Protonica-Detectors/hw-adapter-card/3D Models/TSSOP24_Exposed-pad_STM.step

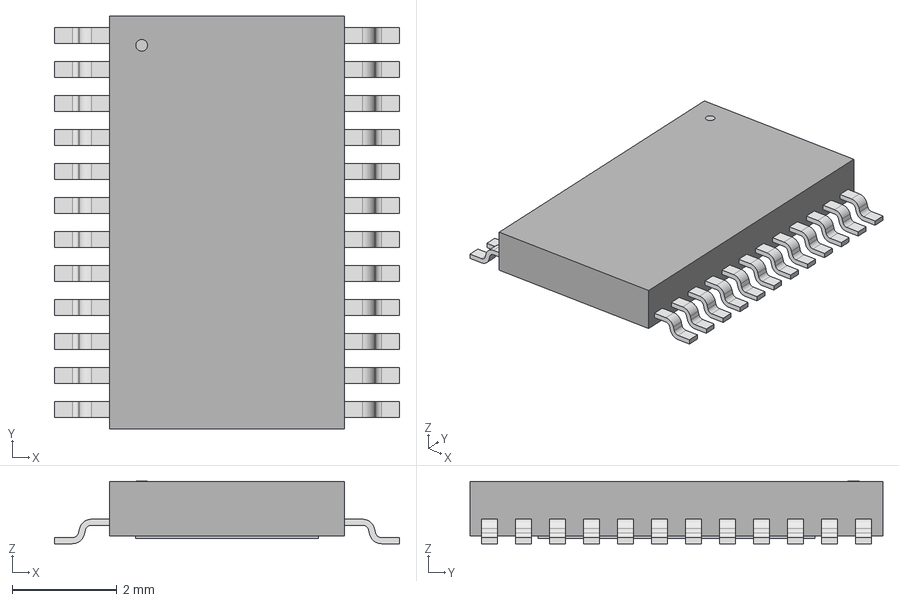
[picture p1: CAD file, 2026-05-28]
3D Models/TSSOP24_Exposed-pad_STM.step
6.60 x 7.90 x 1.20 mm
