Protonica-Detectors/hw-adapter-card/hw-front-end.kicad_pcb

## KiCad design hw-front-end.kicad_pcb (2026-06-15)

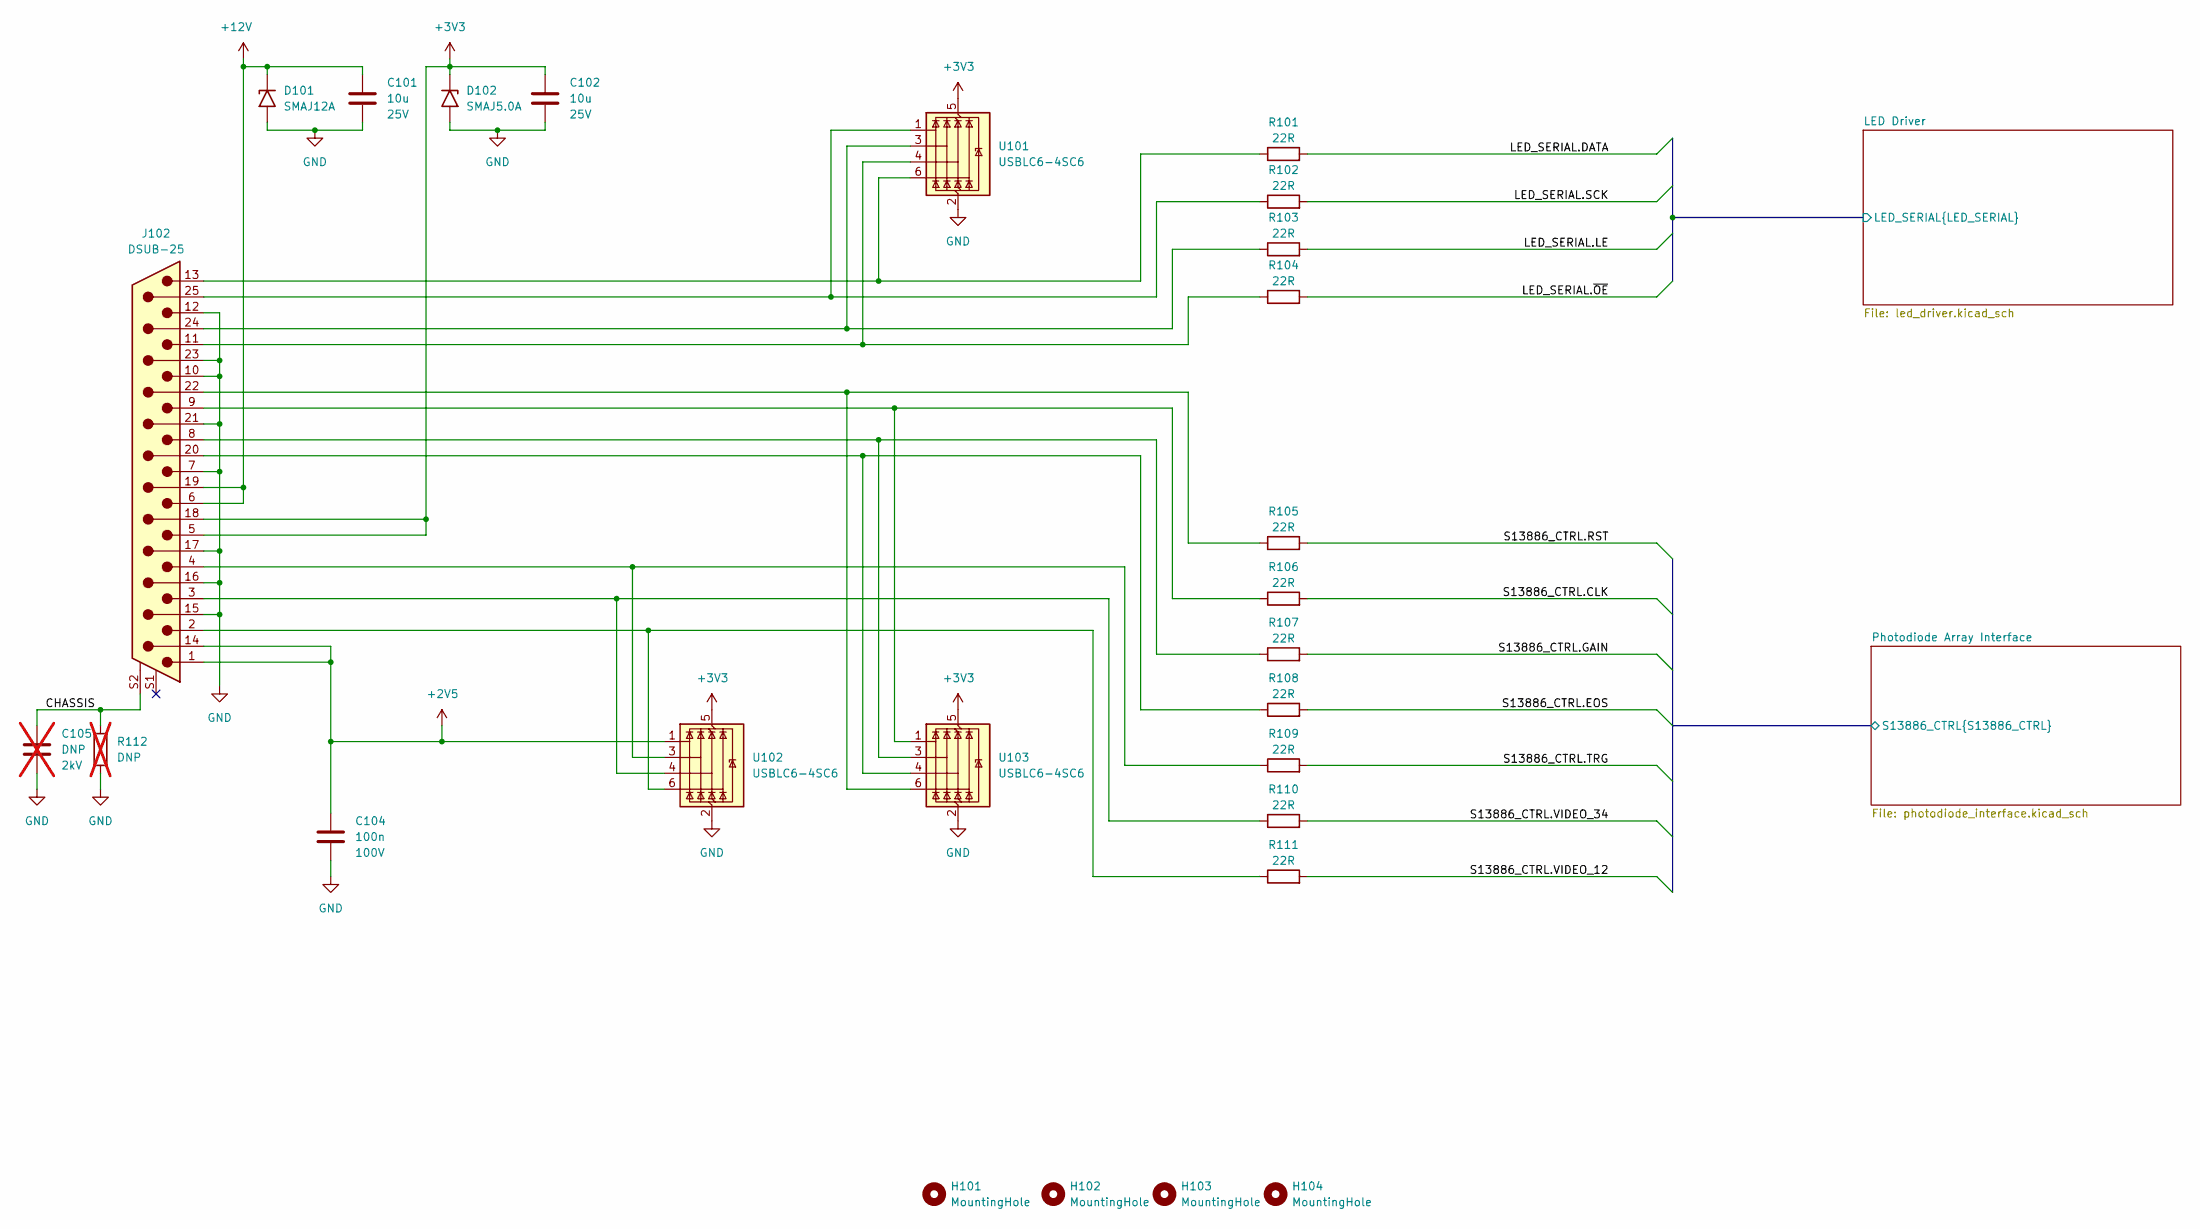
[picture p2: schematic hw-front-end.kicad_sch, Front End Electronics]

Parts:
C101, C102: 10u; C_1206_3216Metric_Pad1.33x1.80mm_HandSolder; Voltage 25V; MPN GRM31CR71E106KA12L
C104: 100n; C_0805_2012Metric_Pad1.18x1.45mm_HandSolder; Voltage 100V; MPN GCM21BR72A104KA37L
C105: DNP; C_1206_3216Metric_Pad1.33x1.80mm_HandSolder; Voltage 2kV; not fitted
D101: SMAJ12A; D_SMA; MPN SMAJ12A
D102: SMAJ5.0A; D_SMA; MPN SMAJ5.0A
H101, H102, H103, H104: MountingHole; MountingHole_3.2mm_M3_DIN965
J102: DSUB-25; J_Wurth_WR-DSUB_618025231221; MPN 618025231221
R101, R102, R103, R104, R105, R106, R107, R108, R109, R110, R111: 22R; R_0805_2012Metric_Pad1.20x1.40mm_HandSolder; MPN CRCW080522R0FKEA
R112: DNP; R_1206_3216Metric_Pad1.30x1.75mm_HandSolder; not fitted
U101, U102, U103: USBLC6-4SC6; SOT-23-6; MPN USBLC6-4SC6

Connections:
+2V5: C104.1, J102.1, J102.14, U102.1 (I/O1); also elsewhere on the board
+3V3: C102.1, D102.1 (A1), J102.5, J102.18, U101.5 (VBUS), U102.5 (VBUS), U103.5 (VBUS); also elsewhere on the board
+12V: C101.1, D101.1 (A1), J102.6, J102.19; also elsewhere on the board
/CHASSIS: C105.1, J102.S2 (SHIELD), R112.1
/LED Driver/LED_SERIAL.DATA: R101.2; also elsewhere on the board
/LED Driver/LED_SERIAL.LE: R103.2; also elsewhere on the board
/LED Driver/LED_SERIAL.SCK: R102.2; also elsewhere on the board
/LED Driver/LED_SERIAL.~OE: R104.2; also elsewhere on the board
/Photodiode Array Interface/S13886_CTRL.CLK: R106.2; also elsewhere on the board
/Photodiode Array Interface/S13886_CTRL.EOS: R108.2; also elsewhere on the board
/Photodiode Array Interface/S13886_CTRL.GAIN: R107.2; also elsewhere on the board
/Photodiode Array Interface/S13886_CTRL.RST: R105.2; also elsewhere on the board
/Photodiode Array Interface/S13886_CTRL.TRG: R109.2; also elsewhere on the board
/Photodiode Array Interface/S13886_CTRL.VIDEO_12: R111.2; also elsewhere on the board
/Photodiode Array Interface/S13886_CTRL.VIDEO_34: R110.2; also elsewhere on the board
GND: C101.2, C102.2, C104.2, C105.2, D101.2 (A2), D102.2 (A2), J102.7, J102.10, J102.12, J102.15, J102.16, J102.17, J102.21, J102.23, R112.2, U101.2 (GND), U102.2 (GND), U103.2 (GND); also elsewhere on the board
unnamed: J102.20, R108.1, U103.4 (I/O3)
unnamed: J102.22, R105.1, U103.6 (I/O4)
unnamed: J102.24, R103.1, U101.3 (I/O2)
unnamed: J102.25, R102.1, U101.1 (I/O1)
unnamed: J102.11, R104.1, U101.4 (I/O3)
unnamed: J102.13, R101.1, U101.6 (I/O4)
unnamed: J102.4, R109.1, U102.3 (I/O2)
unnamed: J102.3, R110.1, U102.4 (I/O3)
unnamed: J102.2, R111.1, U102.6 (I/O4)
unnamed: J102.9, R106.1, U103.1 (I/O1)
unnamed: J102.8, R107.1, U103.3 (I/O2)

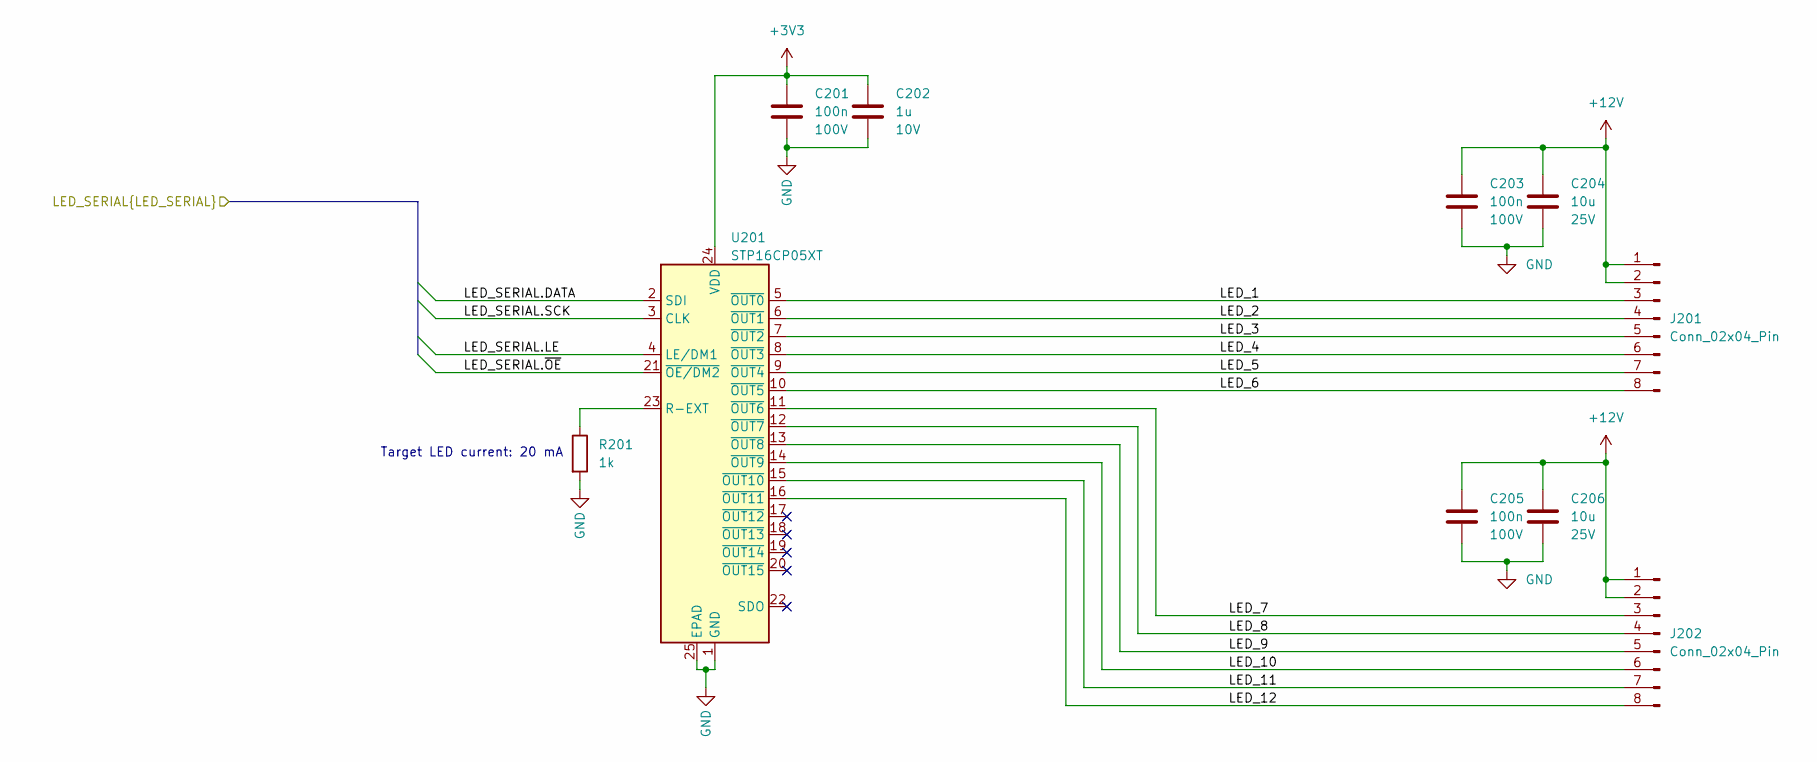
[picture p3: schematic led_driver.kicad_sch, Front End Electronics]

Parts:
C201, C203, C205: 100n; C_0805_2012Metric_Pad1.18x1.45mm_HandSolder; Voltage 100V; MPN GCM21BR72A104KA37L
C202: 1u; C_0805_2012Metric_Pad1.18x1.45mm_HandSolder; Voltage 10V; MPN GRM21BR71A105KA01L
C204, C206: 10u; C_1206_3216Metric_Pad1.33x1.80mm_HandSolder; Voltage 25V; MPN GRM31CR71E106KA12L
J201, J202: Conn_02x04_Pin; PinHeader_2x04_P2.54mm_Vertical; MPN M20-9760442
R201: 1k; R_0805_2012Metric_Pad1.20x1.40mm_HandSolder; MPN CRCW08051K00FKEA
U201: STP16CP05XT; HTSSOP-24-1EP_4.4x7.8mm_P0.65mm_EP3.2x5mm; MPN STP16CP05XTTR

Connections:
+3V3: C201.1, C202.1, U201.24 (VDD); also elsewhere on the board
+12V: C203.1, C204.1, C205.1, C206.1, J201.1, J201.2, J202.1, J202.2; also elsewhere on the board
/LED Driver/LED_1: J201.3, U201.5 (~OUT0)
/LED Driver/LED_2: J201.4, U201.6 (~OUT1)
/LED Driver/LED_3: J201.5, U201.7 (~OUT2)
/LED Driver/LED_4: J201.6, U201.8 (~OUT3)
/LED Driver/LED_5: J201.7, U201.9 (~OUT4)
/LED Driver/LED_6: J201.8, U201.10 (~OUT5)
/LED Driver/LED_7: J202.3, U201.11 (~OUT6)
/LED Driver/LED_8: J202.4, U201.12 (~OUT7)
/LED Driver/LED_9: J202.5, U201.13 (~OUT8)
/LED Driver/LED_10: J202.6, U201.14 (~OUT9)
/LED Driver/LED_11: J202.7, U201.15 (~OUT10)
/LED Driver/LED_12: J202.8, U201.16 (~OUT11)
/LED Driver/LED_SERIAL.DATA: U201.2 (SDI); also elsewhere on the board
/LED Driver/LED_SERIAL.LE: U201.4 (LE/DM1); also elsewhere on the board
/LED Driver/LED_SERIAL.SCK: U201.3 (CLK); also elsewhere on the board
/LED Driver/LED_SERIAL.~OE: U201.21 (~OE/DM2); also elsewhere on the board
GND: C201.2, C202.2, C203.2, C204.2, C205.2, C206.2, R201.2, U201.1 (GND), U201.25 (EPAD); also elsewhere on the board
unnamed: R201.1, U201.23 (R-EXT)

Notes on the sheet:
Target LED current: 20 mA

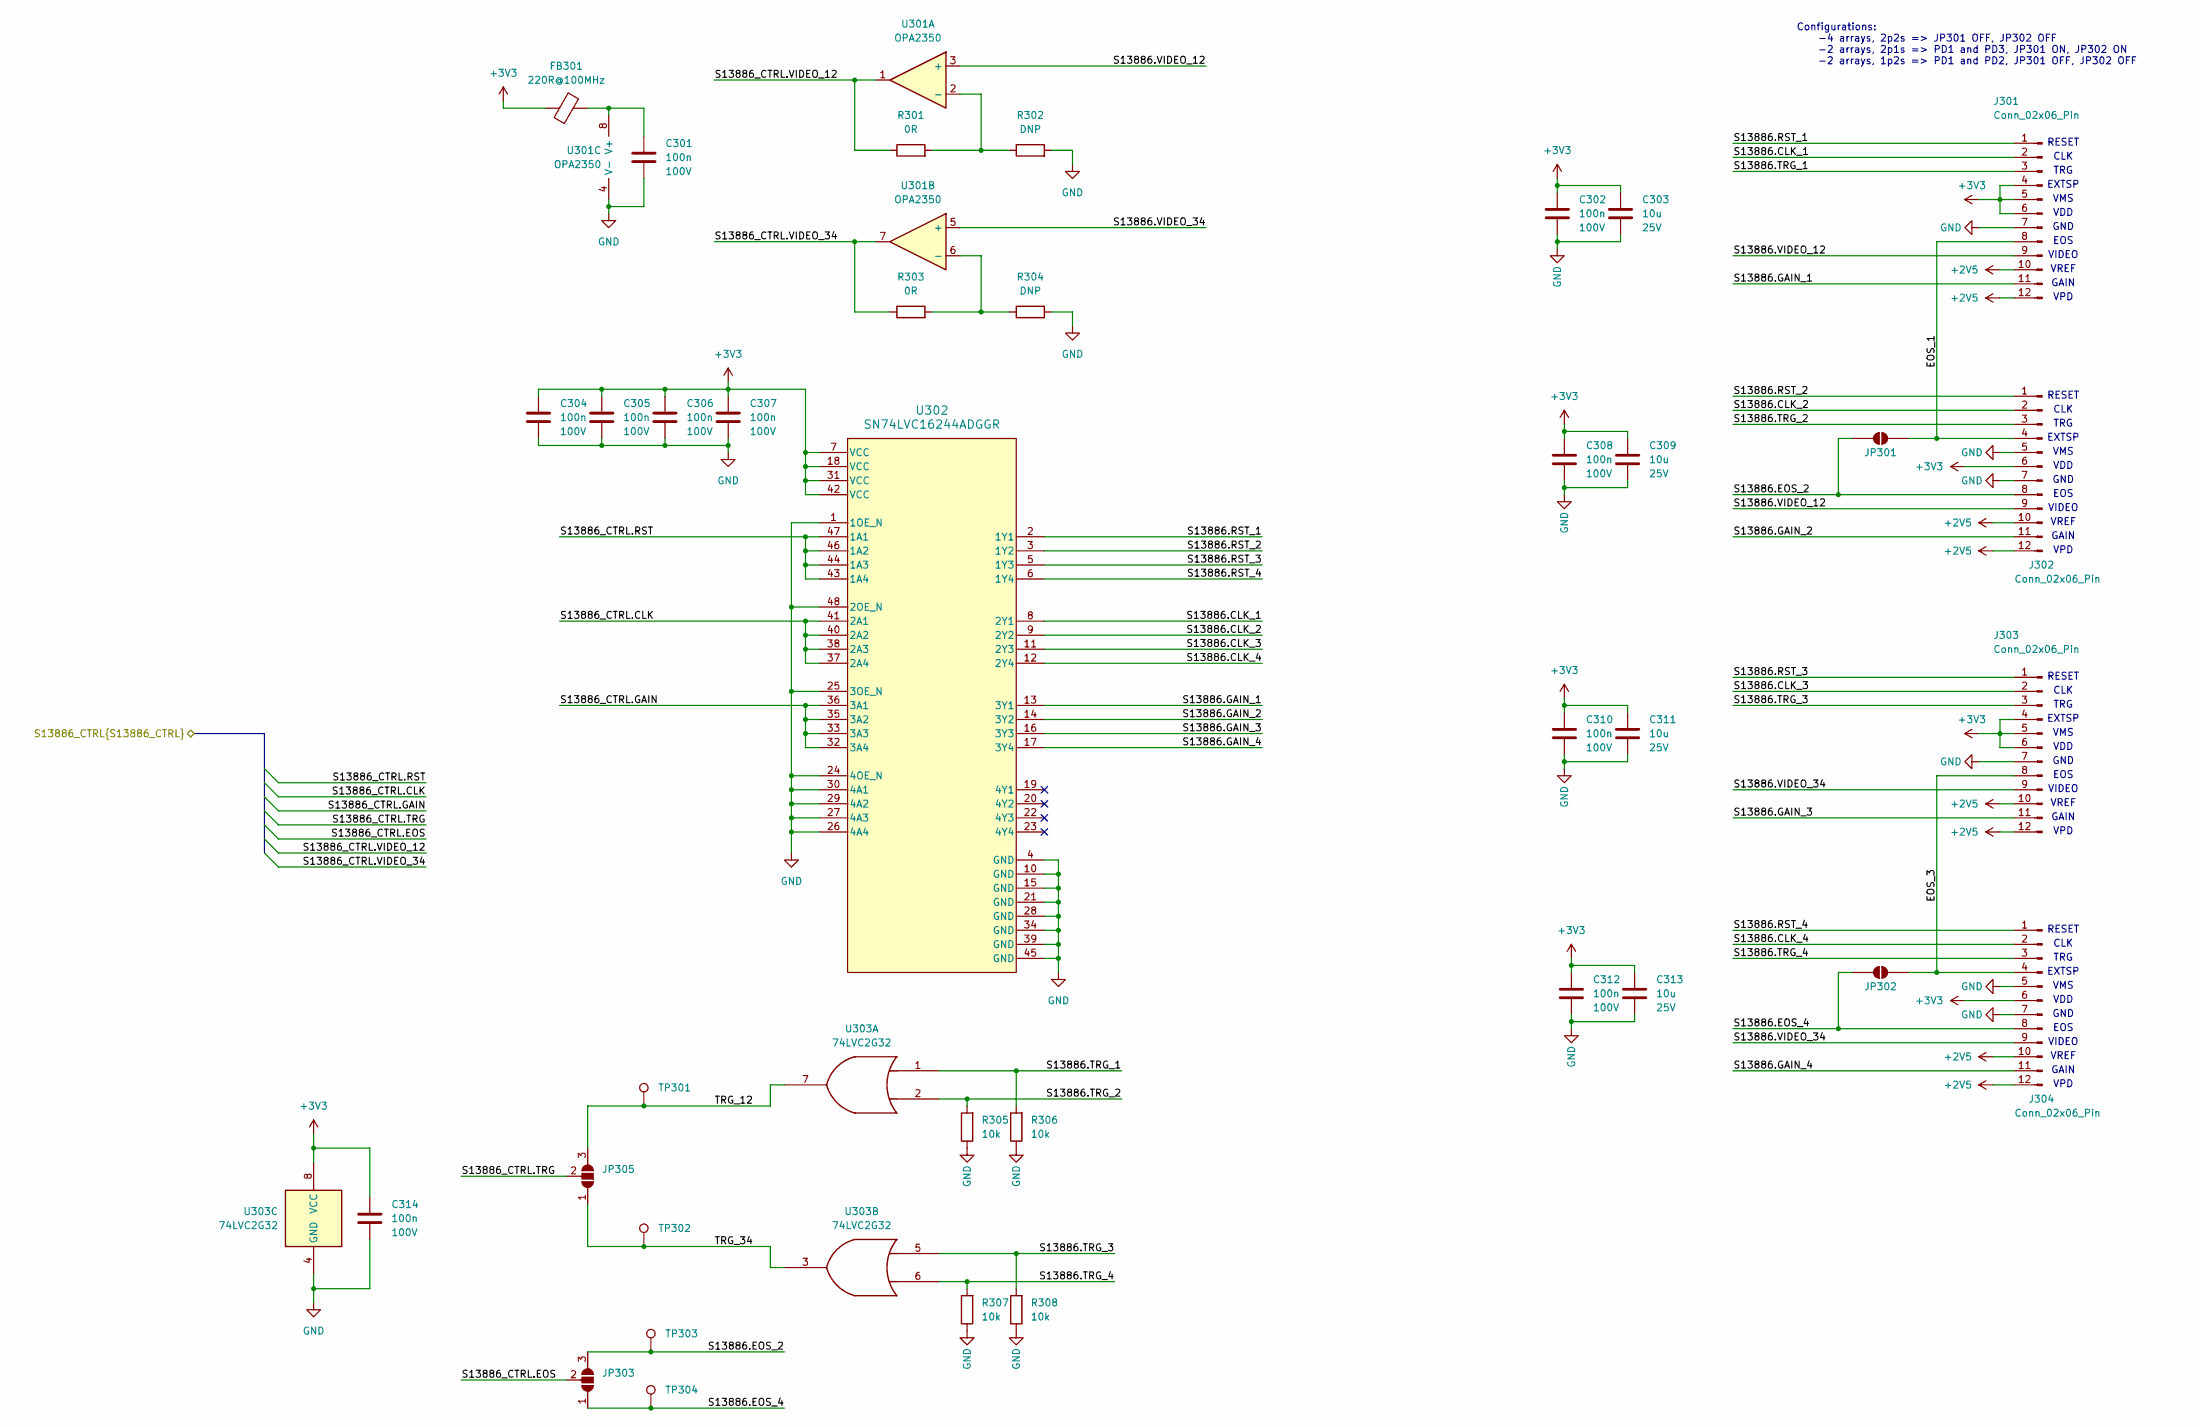
[picture p4: schematic photodiode_interface.kicad_sch, Front End Electronics]

Parts:
C301, C302, C304, C305, C306, C307, C308, C310, C312, C314: 100n; C_0805_2012Metric_Pad1.18x1.45mm_HandSolder; Voltage 100V; MPN GCM21BR72A104KA37L
C303, C309, C311, C313: 10u; C_1206_3216Metric_Pad1.33x1.80mm_HandSolder; Voltage 25V; MPN GRM31CR71E106KA12L
FB301: 220R@100MHz; L_0805_2012Metric_Pad1.05x1.20mm_HandSolder; MPN BLM21PG221SN1D
J301, J302, J303, J304: Conn_02x06_Pin; PinHeader_2x06_P2.54mm_Vertical; MPN M20-9760642
JP301, JP302: SolderJumper_2_Open; SolderJumper-2_P1.3mm_Open_Pad1.0x1.5mm
JP303, JP305: SolderJumper_3_Open; SolderJumper-3_P1.3mm_Open_Pad1.0x1.5mm
R301, R303: 0R; R_0805_2012Metric_Pad1.20x1.40mm_HandSolder; MPN CRCW08050000Z0EA
R302, R304: DNP; R_0805_2012Metric_Pad1.20x1.40mm_HandSolder
R305, R306, R307, R308: 10k; R_0805_2012Metric_Pad1.20x1.40mm_HandSolder; MPN CRCW080510K0FKEA
TP301, TP302, TP303, TP304: TestPoint; TestPoint_Keystone_5005-5009_Compact; MPN 5005
U301: OPA2350; SOIC-8_3.9x4.9mm_P1.27mm; MPN OPA2350UA/2K5
U302: SN74LVC16244ADGGR; TSSOP-48_6.1x12.5mm_P0.5mm; MPN SN74LVC16244ADGGR
U303: 74LVC2G32; VSSOP-8_3x3mm_P0.65mm; MPN SN74LVC2G32DCTR

Connections:
+2V5: J301.10, J301.12, J302.10, J302.12, J303.10, J303.12, J304.10, J304.12; also elsewhere on the board
+3V3: C302.1, C303.1, C304.1, C305.1, C306.1, C307.1, C308.1, C309.1, C310.1, C311.1, C312.1, C313.1, C314.1, FB301.1, J301.4, J301.5, J301.6, J302.6, J303.4, J303.5, J303.6, J304.6, U302.7 (VCC), U302.18 (VCC), U302.31 (VCC), U302.42 (VCC), U303.8 (VCC); also elsewhere on the board
/Photodiode Array Interface/EOS_1: J301.8, J302.4, JP301.1 (A)
/Photodiode Array Interface/EOS_3: J303.8, J304.4, JP302.1 (A)
/Photodiode Array Interface/S13886.CLK_1: J301.2, U302.8 (2Y1)
/Photodiode Array Interface/S13886.CLK_2: J302.2, U302.9 (2Y2)
/Photodiode Array Interface/S13886.CLK_3: J303.2, U302.11 (2Y3)
/Photodiode Array Interface/S13886.CLK_4: J304.2, U302.12 (2Y4)
/Photodiode Array Interface/S13886.EOS_2: J302.8, JP301.2 (B), JP303.3 (B), TP303.1 (1_1)
/Photodiode Array Interface/S13886.EOS_4: J304.8, JP302.2 (B), JP303.1 (A), TP304.1 (1_1)
/Photodiode Array Interface/S13886.GAIN_1: J301.11, U302.13 (3Y1)
/Photodiode Array Interface/S13886.GAIN_2: J302.11, U302.14 (3Y2)
/Photodiode Array Interface/S13886.GAIN_3: J303.11, U302.16 (3Y3)
/Photodiode Array Interface/S13886.GAIN_4: J304.11, U302.17 (3Y4)
/Photodiode Array Interface/S13886.RST_1: J301.1, U302.2 (1Y1)
/Photodiode Array Interface/S13886.RST_2: J302.1, U302.3 (1Y2)
/Photodiode Array Interface/S13886.RST_3: J303.1, U302.5 (1Y3)
/Photodiode Array Interface/S13886.RST_4: J304.1, U302.6 (1Y4)
/Photodiode Array Interface/S13886.TRG_1: J301.3, R306.2, U303.1
/Photodiode Array Interface/S13886.TRG_2: J302.3, R305.2, U303.2
/Photodiode Array Interface/S13886.TRG_3: J303.3, R308.2, U303.5
/Photodiode Array Interface/S13886.TRG_4: J304.3, R307.2, U303.6
/Photodiode Array Interface/S13886.VIDEO_12: J301.9, J302.9, U301.3 (+)
/Photodiode Array Interface/S13886.VIDEO_34: J303.9, J304.9, U301.5 (+)
/Photodiode Array Interface/S13886_CTRL.CLK: U302.37 (2A4), U302.38 (2A3), U302.40 (2A2), U302.41 (2A1); also elsewhere on the board
/Photodiode Array Interface/S13886_CTRL.EOS: JP303.2 (C); also elsewhere on the board
/Photodiode Array Interface/S13886_CTRL.GAIN: U302.32 (3A4), U302.33 (3A3), U302.35 (3A2), U302.36 (3A1); also elsewhere on the board
/Photodiode Array Interface/S13886_CTRL.RST: U302.43 (1A4), U302.44 (1A3), U302.46 (1A2), U302.47 (1A1); also elsewhere on the board
/Photodiode Array Interface/S13886_CTRL.TRG: JP305.2 (C); also elsewhere on the board
/Photodiode Array Interface/S13886_CTRL.VIDEO_12: R301.1, U301.1; also elsewhere on the board
/Photodiode Array Interface/S13886_CTRL.VIDEO_34: R303.1, U301.7; also elsewhere on the board
/Photodiode Array Interface/TRG_12: JP305.3 (B), TP301.1 (1_1), U303.7
/Photodiode Array Interface/TRG_34: JP305.1 (A), TP302.1 (1_1), U303.3
GND: C301.2, C302.2, C303.2, C304.2, C305.2, C306.2, C307.2, C308.2, C309.2, C310.2, C311.2, C312.2, C313.2, C314.2, J301.7, J302.5, J302.7, J303.7, J304.5, J304.7, R302.2, R304.2, R305.1, R306.1, R307.1, R308.1, U301.4 (V-), U302.1 (1OE_N), U302.4 (GND), U302.10 (GND), U302.15 (GND), U302.21 (GND), U302.24 (4OE_N), U302.25 (3OE_N), U302.26 (4A4), U302.27 (4A3), U302.28 (GND), U302.29 (4A2), U302.30 (4A1), U302.34 (GND), U302.39 (GND), U302.45 (GND), U302.48 (2OE_N), U303.4 (GND); also elsewhere on the board
unnamed: R301.2, R302.1, U301.2 (-)
unnamed: R303.2, R304.1, U301.6 (-)
unnamed: C301.1, FB301.2, U301.8 (V+)

Notes on the sheet:
EXTSP
Configurations: -4 arrays, 2p2s => JP301 OFF, JP302 OFF -2 arrays, 2p1s => PD1 and PD3, JP301 ON, JP302 ON -2 arrays, 1p2s => PD1 and PD2, JP301 OFF, JP302 OFF
GND
TRG
VPD
VDD
VIDEO
CLK
EOS
GAIN
RESET
VMS
VREF

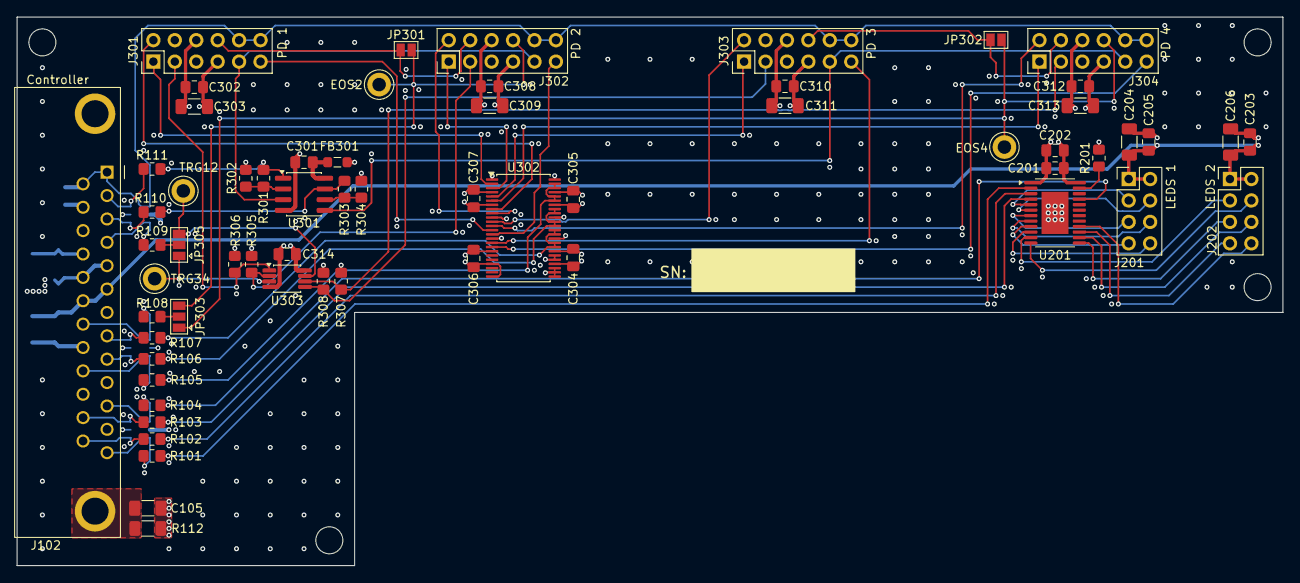
[picture p5: board hw-front-end.kicad_pcb from above]

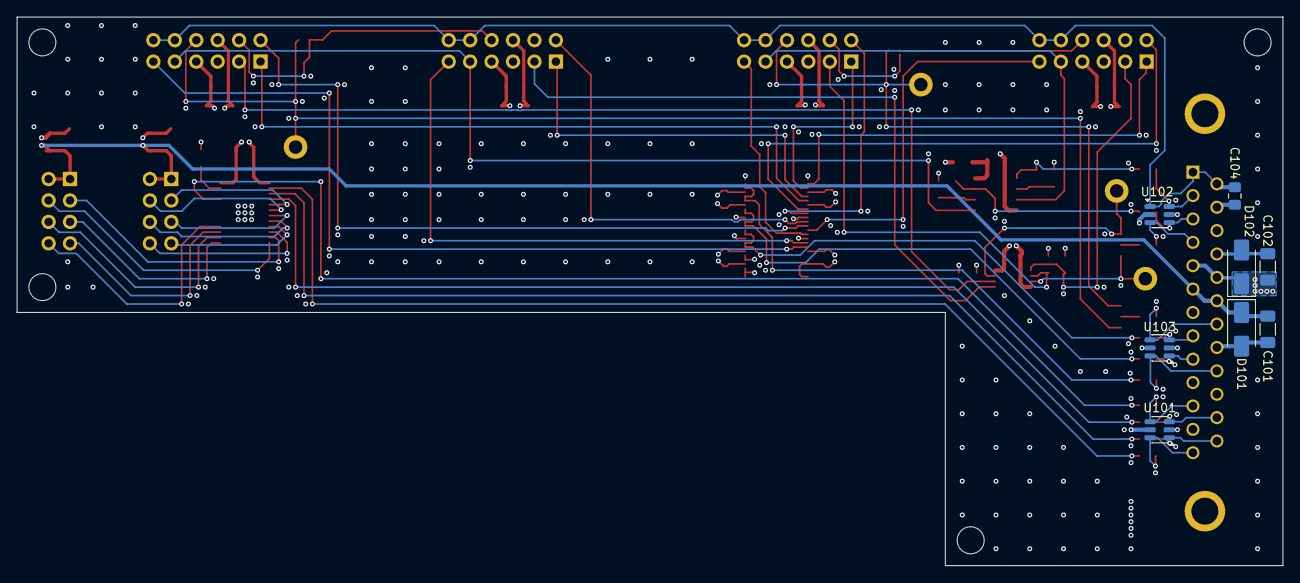
[picture p6: board hw-front-end.kicad_pcb from below]

Board: 6 copper layers, 150.0 x 65.0 mm, 74 parts (8 on the bottom side), 67 nets.
