Protonica-Detectors/hw-adapter-card/(commit log)

2026-04-23 schematic creation ongoing rev B.1
    [hw-adapter-card.kicad_pcb, hw-adapter-card.kicad_sch]
2026-04-29 erc clrean
    [hw-adapter-card.kicad_sch, led_driver.kicad_sch, photodiode_interface.kicad_sch]
2026-05-05 nodified according to review
    [hw-front-end.kicad_sch, led_driver.kicad_sch, photodiode_interface.kicad_sch]
2026-05-05 minor changes
    [hw-front-end.kicad_sch, led_driver.kicad_sch, photodiode_interface.kicad_sch]
2026-05-28 footprints associated to symbols
    [TSSOP24_Exposed-pad_STM.step, hw-adapter-card.kicad_pcb, hw-front-end.kicad_pcb, hw-front-end.kicad_sch, led_driver.kicad_sch, photodiode_interface.kicad_sch]
2026-06-10 Most tracks routed
    [hw-front-end.kicad_pcb, hw-front-end.kicad_sch, led_driver.kicad_sch, photodiode_interface.kicad_sch]
2026-06-10 DRC clean
    [hw-front-end.kicad_pcb, hw-front-end.kicad_sch, photodiode_interface.kicad_sch]
2026-06-11 added stitching vias and silkscreen
    [hw-front-end.kicad_pcb, hw-front-end.kicad_sch, led_driver.kicad_sch, photodiode_interface.kicad_sch]
2026-06-15 updated bom, ready for ordering
    [hw-front-end.kicad_pcb, led_driver.kicad_sch, photodiode_interface.kicad_sch]
